MauroGianchino/Control_Horticultura/documentos/Esquematico/Proyecto_Horticultura_BOM.xls

Comment | Value | Description | Designator | Footprint | Quantity | Código DK
Battery |  | Multicell Battery | BT1 | BAT-2 | 1 | La adecuada para el PCB
Capacitor 100nF | 100nF | Capacitor | C1, C2, C3, C4, C8, C9, C10, C11, C12, C13 | RAD-0.3 | 10 | Cualquier capacitor SMD 1206 o 0603 de 16V o superior
Capacitor 1uF | 1uF | Capacitor | C5, C6 | RAD-0.3 | 2
Capacitor 10nF | 10nF x 400V | Capacitor | C7 | RAD-0.3 | 1 | B32621A6103J000
Capacitor 100uF | 100uF | Capacitor | C14 | RAD-0.3 | 1 | TAJD107K016RNJ
Capacitor 10uF | 10uF | Capacitor | C15 | RAD-0.3 | 1 | TAJD106K025RNJ
Diode_RTC_2 |  | Default Diode | D1 | SMC | 1 | B520LW-7-F
Diode_RTC_1 |  | Default Diode | D2 | SMC | 1
LED_RED |  | Typical INFRARED GaAs LED | D3 | LED-0 | 1 | WP7113SRD/J4
LED_BI_G |  | Typical INFRARED GaAs LED | D4,D5 |  | 1 | L519EGW
LED_BI_R
LED_GREEN |  | Typical INFRARED GaAs LED | D6, D7, D8 | LED-0 | 3 | WP7113GD
Diode_RELE |  | Default Diode | D9 | SMC | 1 | 1N4001 (Diotec semiconductor)
ZENER_5.1V |  | Zener Diode | D10 | DIODE-0.7 | 1 | SMBJ5338B-TP
Relay |  | SPDT Relay | K1 | MODULE5B | 1 | JW1FSN-DC12V
Header 3 |  | Header, 3-Pin | P1, P2, P3, P8 | HDR1X3 | 4 | Elegir según Nestor
MHDR1X10 |  | Header, 10-Pin | P4 | MHDR1X10 | 1 | EA DOGS164W-A
Header 2 |  | Header, 2-Pin | P5, P6, P7 | HDR1X2 | 3 | Elegir según Nestor
IRM-05-12 |  | Power Supply | PS1 | IRM0524 | 1 | IRM-05-12
PNP |  | PNP Bipolar Transistor | Q1 | SOT-23B_L | 1 | FMMT591ATA
NPN |  | NPN Bipolar Transistor | Q2, Q3, Q4, Q5, Q7 | TO-226-AA | 5 | BC817-40,215
Triac |  | Silicon Bidirectional Triode Thyristor | Q6 | 369-03 | 1 | SST137K-600E
Resistor 1k | 1K | Resistor | R1, R3, R25 | AXIAL-0.4 | 3 | Cualquier resistor SMD 1206 o 0603 0.25W al 5% o 1%
Resistor 10k | 10K | Resistor | R2, R10, R11, R15, R16, R18, R19, R20, R21, R22, R27, R28, R29, R30, R31, R32, R33 | AXIAL-0.4 | 17
Resistor 100 | 100 | Resistor | R4, R5, R7, R8, R9 | AXIAL-0.4 | 5
Resistor 50 | 50 | Resistor | R6 | AXIAL-0.4 | 1
Resistor 47k | 47k x 1W | Resistor | R12 | AXIAL-0.4 | 1 | Cualquier resistor con esas caracteristicas
Resistor 180k | 180K 1% | Resistor | R13 | AXIAL-0.4 | 1
Resistor 18k 1% | 18K 1% | Resistor | R14 | AXIAL-0.4 | 1
RPot | 100K | Potentiometer | R17 | VR5 | 1 | Elegir según Nestor
Resistor 390 | 390 | Resistor | R23, R26 | AXIAL-0.4 | 2 | Cualquier resistor con esas caracteristicas
Resistor 39 | 39 x 1W | Resistor | R24 | AXIAL-0.4 | 1
Resistor 1 | 1 x 1W | Resistor | R34 | AXIAL-0.4 | 1
SW-PB |  | Switch | S1, S2, S3, S4, S5, S6 | SPST-2 | 6 | A elegir por Nestor
Opto TRIAC |  | Opto-Triac | T1 | NPSIP4A | 1 | VO3063-X007T
ESP32-WROOM-UE32 |  | ESP32 uC | U1 |  | 1 | ESP32-WROOM-32UE-N16
LM1117MPX-3.3_NOPB |  | Integrated Circuit | U2 | SOT230P700X180-4N | 1 | LM1117MPX-3.3/NOPB
PCF85063ATT_AJ |  | Integrated Circuit | U3 | SOP65P490X110-8N | 1 | PCF85063ATT/AJ
Jumper |  | Jumper Wire | W1 | RAD-0.2 | 1 | Jumepr normal
32.768kHz |  | Crystal Oscillator | Y1 | R38 | 1 | ECS-.327-CDX-1082
