MauroGianchino/Control_Horticultura/documentos/WiFi-PWM  v02.pdf

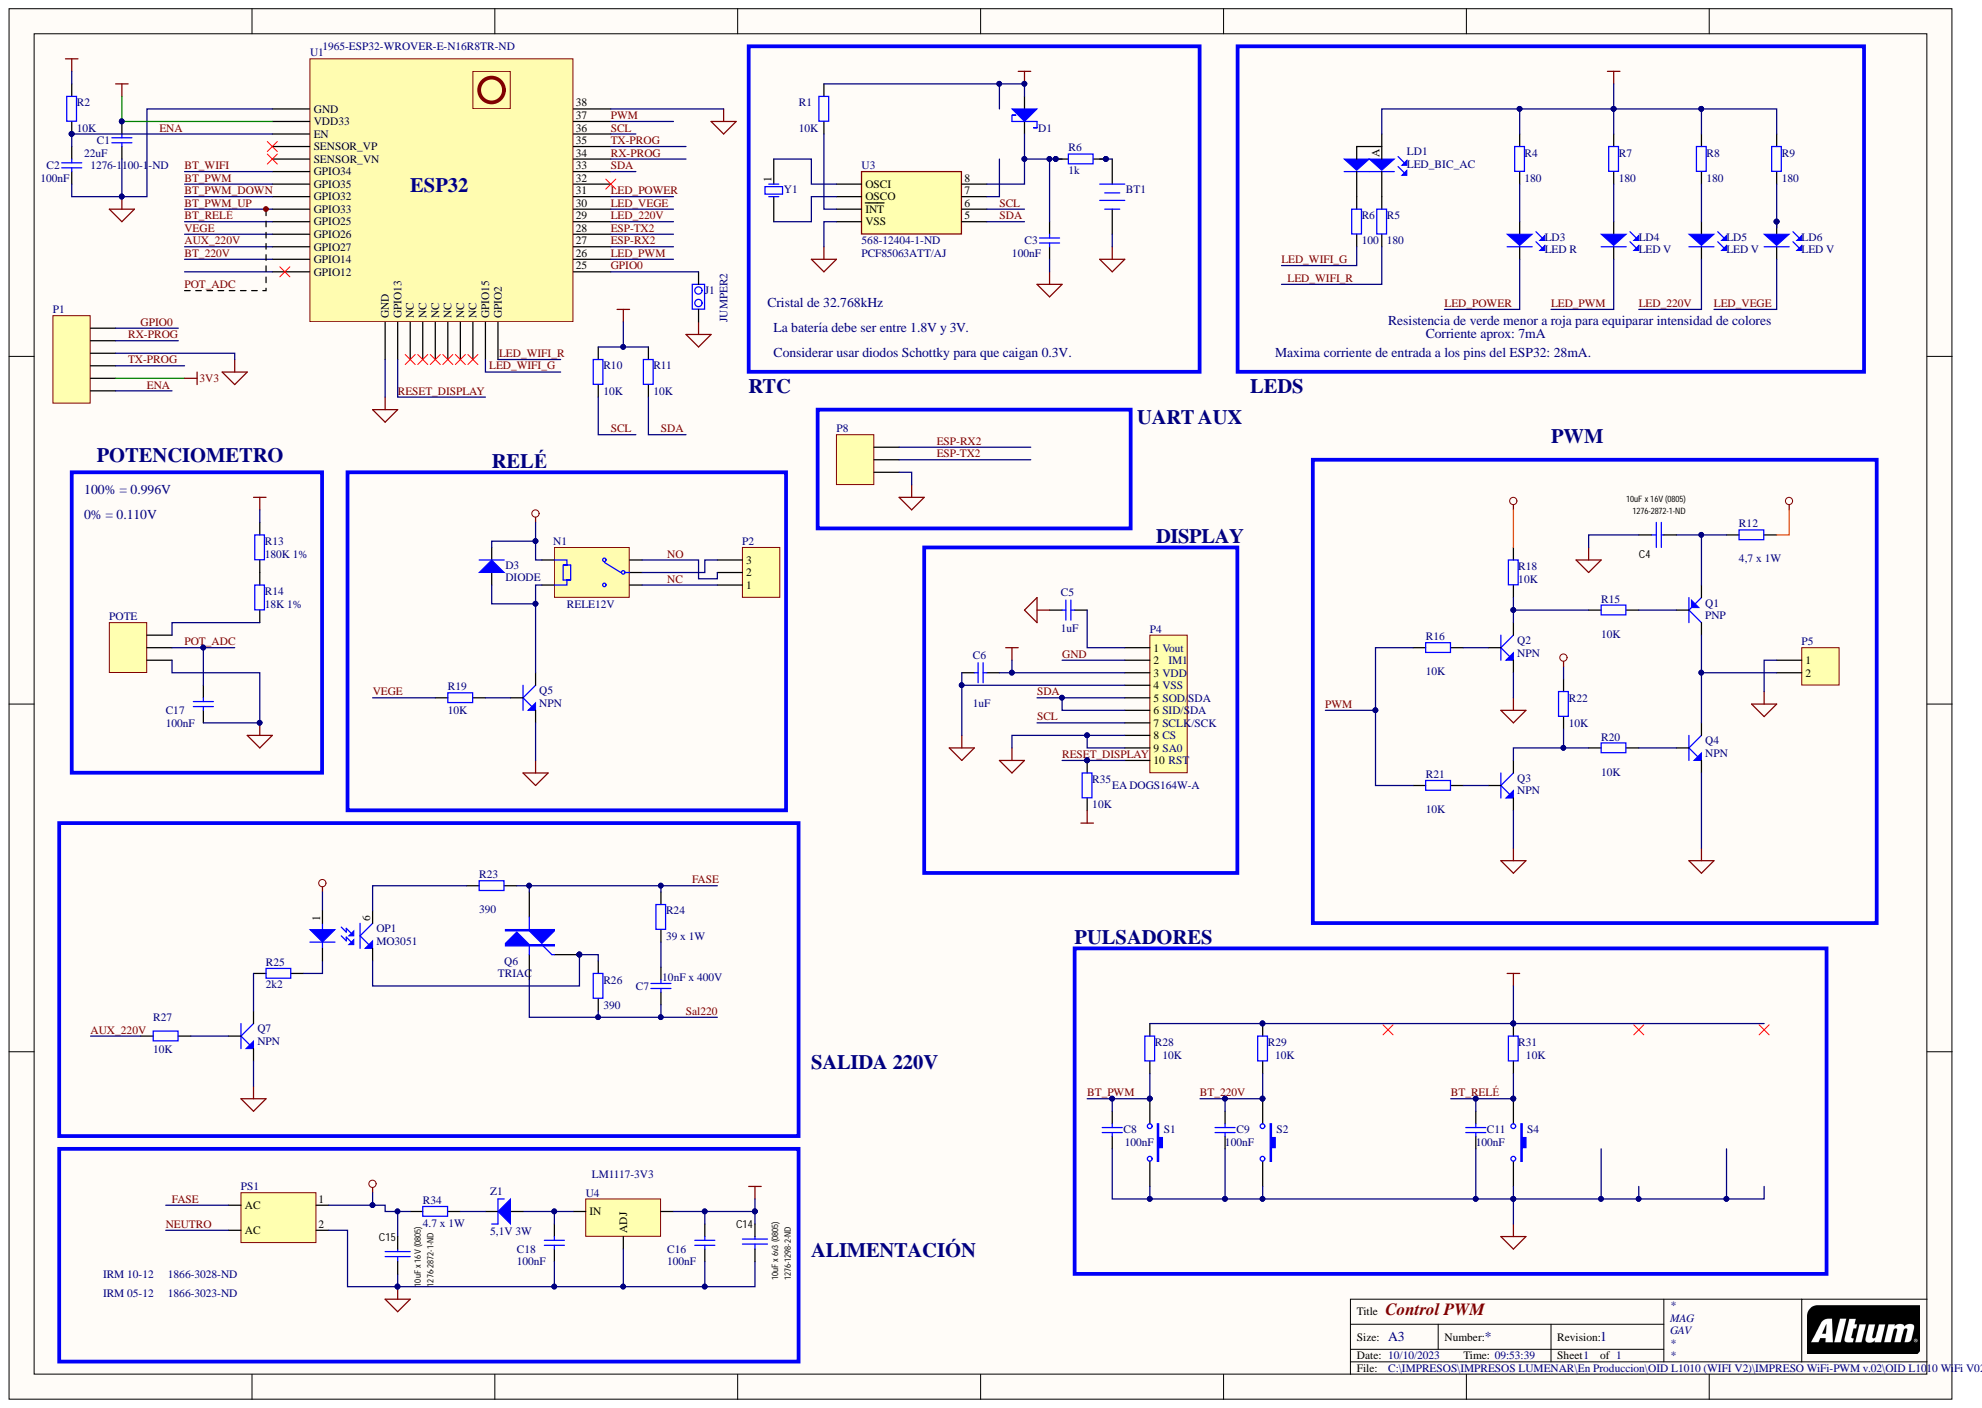
[picture p1: page 1]

La batería debe ser entre 1.8V y 3V.

Resistencia de verde menor a roja para equiparar intensidad de colores

Considerar usar diodos Schottky para que caigan 0.3V.

Maxima corriente de entrada a los pins del ESP32: 28mA.

Control PWM Title | * MAG GAV * *

Size: A3 | Number: * | Revision: 1
Date: 10/10/2023 Time: 09:53:39 | | Sheet 1 of 1

C:\IMPRESOS\IMPRESOS LUMENAR\En Produccion\OID L1010 (WIFI V2)\IMPRESO WiFi-PWM v.02\OID L1010 WiFi V02.SchDoc
