MauroGianchino/Control_Horticultura/(list of files, drawings)

Other design files:
documentos/Esquematico/Esquematico.SchDoc
