MauroGianchino/Control_Horticultura/src/button_manager.c

// NOTAS: No se puede printear ni loguear desde una ISR se reinicia el ESP32.
//--------------------INCLUDES--------------------------------------------------
//------------------------------------------------------------------------------
#include <stdio.h>

#include "freertos/FreeRTOS.h"
#include "freertos/task.h"
#include "freertos/queue.h"
#include "driver/gpio.h"
#include "sdkconfig.h"
#include "esp_log.h"

#include "esp_timer.h"

#include "../include/button_manager.h"
#include "../include/board_def.h"
#include "../include/global_manager.h"
#include "../include/nv_flash_driver.h"
#include "../include/analog_input_manager.h"
#include "../include/led_manager.h"
//--------------------MACROS Y DEFINES------------------------------------------
//------------------------------------------------------------------------------
#define QUEUE_ELEMENT_QUANTITY 20

#define TIEMPO_ANTIRREBOTE_MS 50
#define TIEMPO_PULSADO_MS 3000

//#define DEBUG_MODULE
//TO DO: ver el tema del button wifi y los led wifi
//------------------------------TYPEDEF-----------------------------------------
//------------------------------------------------------------------------------
typedef enum{
    CMD_UNDEFINED,
    STARTUP,
    DEVICE_MODE_BUTTON_PUSHED,
    TRIAC_BUTTON_PUSHED,
    VEGE_BUTTON_PUSHED,
    FABRIC_RESET,
    CALIBRATE_POTE,
}cmds_t;

typedef struct{
    cmds_t cmd;
    device_mode_status_t device_mode;
    output_mode_t triac_output_status;
}button_events_t;
//--------------------DECLARACION DE DATOS INTERNOS-----------------------------
//------------------------------------------------------------------------------
static QueueHandle_t button_manager_queue;

volatile int64_t start_time = 0;
volatile int64_t start_time_triac = 0;
volatile int64_t start_time_vege = 0;
//--------------------DECLARACION DE FUNCIONES INTERNAS-------------------------
//------------------------------------------------------------------------------
static void button_event_manager_task(void * pvParameters);

static void config_buttons_isr(void);

static void device_mode_button_interrupt(void *arg);
static void triac_button_interrupt(void *arg);
static void vege_button_interrupt(void *arg);
//--------------------DEFINICION DE DATOS INTERNOS------------------------------
//------------------------------------------------------------------------------

//--------------------DEFINICION DE DATOS EXTERNOS------------------------------
//------------------------------------------------------------------------------

//--------------------DEFINICION DE FUNCIONES INTERNAS--------------------------
//------------------------------------------------------------------------------
static void config_buttons_isr(void)
{
    gpio_config_t config;

    config.pin_bit_mask = (1ULL << VEGE_BUTTON);
    config.mode = GPIO_MODE_INPUT;
    config.pull_up_en = GPIO_PULLDOWN_ENABLE;
    config.pull_down_en = GPIO_PULLDOWN_DISABLE;
    config.intr_type = GPIO_INTR_ANYEDGE;
    gpio_config(&config);
    
    config.pin_bit_mask = (1ULL << DEVICE_MODE_BUTTON);
    config.mode = GPIO_MODE_INPUT;
    config.pull_up_en = GPIO_PULLDOWN_DISABLE;
    config.pull_down_en = GPIO_PULLDOWN_DISABLE;
    config.intr_type = GPIO_INTR_ANYEDGE;
    gpio_config(&config);

    config.pin_bit_mask = (1ULL << TRIAC_BUTTON);
    config.mode = GPIO_MODE_INPUT;
    config.pull_up_en = GPIO_PULLDOWN_DISABLE;
    config.pull_down_en = GPIO_PULLDOWN_DISABLE;
    config.intr_type = GPIO_INTR_ANYEDGE;
    gpio_config(&config);

    // Configurar la interrupción del botón
    gpio_install_isr_service(0);
    gpio_isr_handler_add(DEVICE_MODE_BUTTON, device_mode_button_interrupt, NULL);
    gpio_isr_handler_add(TRIAC_BUTTON, triac_button_interrupt, NULL);
    gpio_isr_handler_add(VEGE_BUTTON, vege_button_interrupt, NULL);
}
//------------------------------------------------------------------------------
static void IRAM_ATTR device_mode_button_interrupt(void *arg) 
{
    button_events_t ev;
    int64_t time_now = esp_timer_get_time();

    if(gpio_get_level(DEVICE_MODE_BUTTON) == 0)
    {
        start_time = time_now;
    }
    else 
    {
        if (start_time != 0)
        {
            int64_t diff = time_now - start_time;

            if (diff > 30000)  // 30ms seconds expressed in microseconds
            {
                ev.cmd = DEVICE_MODE_BUTTON_PUSHED;
                start_time = 0;
                xQueueSendFromISR(button_manager_queue, &ev, pdFALSE);
            }
            if (diff > 7000000)  // 7 seconds expressed in microseconds
            {
                ev.cmd = FABRIC_RESET;
                start_time = 0;
                xQueueSendFromISR(button_manager_queue, &ev, pdFALSE);
            }
            start_time = 0;
        }
    }
}
//------------------------------------------------------------------------------
static void IRAM_ATTR triac_button_interrupt(void *arg) 
{
    button_events_t ev;
    int64_t time_now = esp_timer_get_time();

    if(gpio_get_level(TRIAC_BUTTON) == 0)
    {
        start_time_triac = time_now;
    }
    else 
    {
        if (start_time_triac != 0)
        {
            int64_t diff = time_now - start_time_triac;
            if (diff > 30000)  // 30ms seconds expressed in microseconds
            {
                ev.cmd = TRIAC_BUTTON_PUSHED;
                start_time_triac = 0;
                xQueueSendFromISR(button_manager_queue, &ev, pdFALSE);
            }
            if (diff > 7000000) // 7 seconds expressed in microseconds
            {
                ev.cmd = CALIBRATE_POTE;
                start_time_triac = 0;
                xQueueSendFromISR(button_manager_queue, &ev, pdFALSE);
            }
            start_time_triac = 0;
            
        }
    }
}
//------------------------------------------------------------------------------
static void IRAM_ATTR vege_button_interrupt(void *arg) 
{
    button_events_t ev;
    int64_t time_now = esp_timer_get_time();

    if(gpio_get_level(VEGE_BUTTON) == 0)
    {
        start_time_vege = time_now;
    }
    else 
    {
        if (start_time_vege != 0)
        {
            int64_t diff = time_now - start_time_vege;

            if (diff > 30000)  // 30ms seconds expressed in microseconds
            {
                ev.cmd = VEGE_BUTTON_PUSHED;
                xQueueSendFromISR(button_manager_queue, &ev, pdFALSE);
            }
            start_time_vege = 0;
        }
    }
}
//------------------------------------------------------------------------------
void button_manager_send_startup_info(device_mode_status_t device_mode, output_mode_t triac_output_status)
{
    button_events_t ev;
    ev.cmd = STARTUP;
    ev.device_mode = device_mode;
    ev.triac_output_status = triac_output_status;
    xQueueSend(button_manager_queue, &ev, 30 / portTICK_PERIOD_MS);
    
}


void button_event_manager_task(void * pvParameters)
{
    button_events_t button_ev;
    
    device_mode_status_t device_mode = DEVICE_IN_MANUAL;
    output_mode_t triac_status = MANUAL_OFF;
    rele_output_status_t rele_vege_status = RELE_VEGE_DISABLE;
#ifdef DIGITAL_POTE
    uint8_t pwm_percent_power = 0;
#endif

    config_buttons_isr();

    while(true)
    {
        if(xQueueReceive(button_manager_queue, &button_ev, portMAX_DELAY) == pdTRUE)
        {
            switch(button_ev.cmd)
            {
                case STARTUP:
                    device_mode = button_ev.device_mode;
                    triac_status = button_ev.triac_output_status;
                    break;
                case CMD_UNDEFINED:
                    break;
                case DEVICE_MODE_BUTTON_PUSHED:
                    led_manager_new_update();
                    if(device_mode == DEVICE_IN_MANUAL)
                    {
                        global_manager_set_triac_mode_off(false);
                        triac_status = MANUAL_ON;       
                        global_manager_set_pwm_mode_manual_on();
                        device_mode = DEVICE_IN_AUTOMATIC;
                        analog_input_send_pwm_mode(MANUAL_ON);
                        
                    }
                    else if(device_mode == DEVICE_IN_AUTOMATIC)
                    {
                        analog_input_send_pwm_mode(AUTOMATIC);
                        global_manager_set_pwm_mode_auto();
                        global_manager_set_triac_mode_auto(false);
                        device_mode = DEVICE_IN_MANUAL;
                    }
                    break;
                case TRIAC_BUTTON_PUSHED:
                    led_manager_new_update();
                    if(device_mode == DEVICE_IN_AUTOMATIC)
                    {
                        if(triac_status == MANUAL_OFF)
                        {
                            global_manager_set_triac_mode_off(false);
                            triac_status = MANUAL_ON;
                        }
                        else if(triac_status == MANUAL_ON)
                        {
                            global_manager_set_triac_mode_manual_on(false);
                            triac_status = MANUAL_OFF;
                        }
                    }
                    break;
                case VEGE_BUTTON_PUSHED:
                    led_manager_new_update();
                    if(rele_vege_status == RELE_VEGE_DISABLE)
                    {
                        global_manager_set_rele_vege_status_off(false);
                        rele_vege_status = RELE_VEGE_ENABLE;
                    }
                    else if(rele_vege_status == RELE_VEGE_ENABLE)
                    {
                        global_manager_set_rele_vege_status_on(false);
                        rele_vege_status = RELE_VEGE_DISABLE;
                    }
                    break;
                case FABRIC_RESET:
                    led_manager_new_update();
                    nv_flash_driver_erase_flash();
                    break;
                case CALIBRATE_POTE:
                    led_manager_new_update();
                    analog_input_calibrate_pote();
                    break;
                default:
                break;
            }
        }
    }
}
//--------------------DEFINICION DE FUNCIONES EXTERNAS--------------------------
//------------------------------------------------------------------------------
void button_manager_init(void)
{
    button_manager_queue = xQueueCreate(QUEUE_ELEMENT_QUANTITY, sizeof(button_events_t));

    xTaskCreate(button_event_manager_task, "button_event_manager_task", 
               configMINIMAL_STACK_SIZE*5, NULL, configMAX_PRIORITIES, NULL);             
}
//--------------------FIN DEL ARCHIVO-------------------------------------------
//------------------------------------------------------------------------------
