MauroGianchino/Control_Horticultura/src/version.c

//--------------------INCLUDES--------------------------------------------------
//------------------------------------------------------------------------------
#include <stdio.h>
#include <string.h>
#include <assert.h>

#include "sdkconfig.h"

#include "../include/version.h"
//--------------------MACROS Y DEFINES------------------------------------------
//------------------------------------------------------------------------------
#define VERSION "2.3"
//------------------- TYPEDEF --------------------------------------------------
//------------------------------------------------------------------------------

//------------------- DECLARACION DE DATOS LOCALES -----------------------------
//------------------------------------------------------------------------------

//------------------- DECLARACION DE FUNCIONES LOCALES -------------------------
//------------------------------------------------------------------------------

//------------------- DEFINICION DE DATOS LOCALES ------------------------------
//------------------------------------------------------------------------------

//------------------- DEFINICION DE DATOS GLOBALES -----------------------------
//------------------------------------------------------------------------------

//------------------- DEFINICION DE FUNCIONES LOCALES --------------------------
//------------------------------------------------------------------------------

//------------------- DEFINICION DE FUNCIONES EXTERNAS -------------------------
//------------------------------------------------------------------------------
void get_version(char *version, uint8_t *version_len)
{
    strcpy(version, VERSION);
    *version_len = strlen(version);
}
//---------------------------- END OF FILE -------------------------------------
//------------------------------------------------------------------------------
