MauroGianchino/Control_Horticultura/include/button_manager.h

#ifndef BUTTON_MANAGER_H__
#define BUTTON_MANAGER_H__
//--------------------INCLUDES--------------------------------------------------
//------------------------------------------------------------------------------
#include "../include/global_manager.h"

//--------------------MACROS Y DEFINES------------------------------------------
//------------------------------------------------------------------------------

//--------------------TYPEDEF---------------------------------------------------
//------------------------------------------------------------------------------
typedef enum{
    DEVICE_IN_MANUAL = 0,
    DEVICE_IN_AUTOMATIC = 1,
}device_mode_status_t;
//--------------------DECLARACION DE DATOS EXTERNOS-----------------------------
//------------------------------------------------------------------------------

//--------------------DECLARACION DE FUNCIONES EXTERNAS-------------------------
//------------------------------------------------------------------------------
void button_manager_init(void);
void button_manager_send_startup_info(device_mode_status_t device_mode, output_mode_t triac_output_status);

//--------------------FIN DEL ARCHIVO-------------------------------------------
#endif /* BUTTON_MANAGER_H__ */
