MauroGianchino/Control_Horticultura/include/pcf85063.h

#ifndef PCF85063_H__
#define PCF85063_H__
//------------------- INCLUDES -------------------------------------------------
//------------------------------------------------------------------------------

//------------------- MACROS Y DEFINES -----------------------------------------
//------------------------------------------------------------------------------

//------------------- TYPEDEF --------------------------------------------------
//------------------------------------------------------------------------------

//------------------- DECLARACION DE DATOS EXTERNOS ----------------------------
//------------------------------------------------------------------------------

//------------------- DECLARACION DE FUNCIONES EXTERNAS ------------------------
//------------------------------------------------------------------------------
void pcf85063_init(void);
void pcf85063_set_current_time(struct tm current_time);
uint8_t pcf85063_get_current_time_info(struct tm *current_time);

//------------------- FIN DEL ARCHIVO ------------------------------------------
#endif /* PCF85063_H__ */
