MauroGianchino/Control_Horticultura/include/wifi_manager.h

#ifndef WIFI_MANAGER_H__
#define WIFI_MANAGER_H__
//------------------- INCLUDES -------------------------------------------------
//------------------------------------------------------------------------------

//------------------- MACROS Y DEFINES -----------------------------------------
//------------------------------------------------------------------------------

//------------------- TYPEDEF --------------------------------------------------
//------------------------------------------------------------------------------

//------------------- DECLARACION DE DATOS EXTERNOS ----------------------------
//------------------------------------------------------------------------------

//------------------- DECLARACION DE FUNCIONES EXTERNAS ------------------------
//------------------------------------------------------------------------------
void wifi_manager_init(void);

//------------------- FIN DEL ARCHIVO ------------------------------------------
#endif /* WIFI_MANAGER_H__ */
