MauroGianchino/Control_Horticultura/include/vege_manager.h

#ifndef VEGE_MANAGER_H__
#define VEGE_MANAGER_H__
//------------------- INCLUDES -------------------------------------------------
//------------------------------------------------------------------------------

//------------------- MACROS Y DEFINES -----------------------------------------
//------------------------------------------------------------------------------

//------------------- TYPEDEF --------------------------------------------------
//------------------------------------------------------------------------------

//------------------- DECLARACION DE DATOS EXTERNOS ----------------------------
//------------------------------------------------------------------------------

//------------------- DECLARACION DE FUNCIONES EXTERNAS ------------------------
//------------------------------------------------------------------------------
void vege_manager_init(void);

void vege_manager_turn_on(void);
void vege_manager_turn_off(void);
//------------------- FIN DEL ARCHIVO ------------------------------------------
#endif /* VEGE_MANAGER_H__ */
