MauroGianchino/Control_Horticultura/include/triac_manager.h

#ifndef TRIAC_MANAGER_H__
#define TRIAC_MANAGER_H__
//------------------- INCLUDES -------------------------------------------------
//------------------------------------------------------------------------------

//------------------- MACROS Y DEFINES -----------------------------------------
//------------------------------------------------------------------------------

//------------------- TYPEDEF --------------------------------------------------
//------------------------------------------------------------------------------

//------------------- DECLARACION DE DATOS EXTERNOS ----------------------------
//------------------------------------------------------------------------------

//------------------- DECLARACION DE FUNCIONES EXTERNAS ------------------------
//------------------------------------------------------------------------------
void triac_manager_init(void);

void triac_manager_turn_on_triac(void);
void triac_manager_turn_off_triac(void);
//------------------- FIN DEL ARCHIVO ------------------------------------------
#endif /* TRIAC_MANAGER_H__ */
