MauroGianchino/Control_Horticultura/(commit log)

2023-05-24 Update led_manager_module
2023-05-25 Update platform.ini
    Configuration:
    platform = espressif32
    board = esp32dev
    framework = espidf
    monitor_speed = 115200
    Upload_port = COM3
    build_type = release
    board_upload.flash_size = 4MB
    monitor_filters = esp32_exception_decoder
2023-05-25 New board_def.h module
    Module for board definitions
2023-05-25 Update led manager module with device leds
2023-05-26 Update led manager module
    New functions to interact with led module from other modules.
2023-05-27 Update led manager module
    New functions to manage leds states
2023-05-28 Updating led module with blinking leds
2023-05-29 agrego primera version de esquematico
2023-05-29 Ajuste de valores
2023-05-31 New module button_manager
    Button push detection is managed with external interrupts
2023-05-31 Updating button manager
2023-05-31 update board_def module with pin definitions
2023-05-31 Actualizacion de esquemático. Cambio de simbolo de ESP32. Valores de potenciometro. Resistencias de LEDS
2023-06-01 Update develop_pulsadores
    The module has been updated with the isrs
    for all button readings.
2023-06-01 creo nueva branch y nueva version de esquematico. Asigné lo pines al ESP32 y agregue los capacitores a los botones.
2023-06-01 removi el esquematico V2
2023-06-02 agregaod de uart auxiliar
2023-06-03 Correcciones de esquematico y agrada de lista de componentes
    [Proyecto_Horticultura_BOM.xls]
2023-06-03 Upgrading led_manager and button_manager module
2023-06-03 update board_def
2023-06-03 agrego detalles de la bateria
2023-06-03 agrego archivo del Altium
    [Esquematico.SchDoc]
2023-06-08 arreglo el led bicolor y cambio jumper por pulsador
    [Esquematico.SchDoc]
2023-07-31 Update button manager module
2023-07-31 New module pwm_manager
2023-07-31 Update pwm module
    Added functions for turning on and off pwm while
    day simulation function is turn on
2023-07-31 New feature: pwm automatic manager
2023-07-31 Code working on prototype
    must use esp-prog for programming
    [custom.csv]
2023-07-31 Update buttons module
2023-07-31 Init and save pwm mode on flash
2023-07-31 Resuelto: TO DO: resolver el problema lectura str
    [nv_flash_manager.c]
2023-07-31 Update pwm auto calendar from flash done
2023-07-31 testing pwm auto mode
2023-07-31 PWM AUTO done
2023-07-31 save current time on flash done
2023-07-31 update rele vege
    hay que ver que onda porque no mueve la salida
2023-08-01 agrego los modulos de ap y webserver. Cambio lo de la memoria a 4MB
    [custom.csv]
2023-08-01 agrego los ceros en la web para numeros menores a 10
2023-08-02 agrego las funciones de global manager para guardar los valores de todos los parametros. Falta usar las de lectura para mostrarlas en la web
2023-08-04 agrego el modulo del current_time
2023-08-06 agrego la lectura de todos los parametros a partir de las funciones de gaston. Hay problemas con el triac y vegeflor, que esta levantando mal los datos. tambien falta hacer el cambio de ssid y passwo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
    [global_manager.c, web_server.c, web_server.h, wifi_ap.c]
2023-08-06 solve wb_server get_triac issue
    [custom.csv]
2023-08-07 Change ADC_POTE pin from GPIO 12 to GPIO33
    Due a problema while Aorking with ADC2 and WIFI module
    [analog_input_manager.c, board_def.h, button_manager.c, current_time_manager.c, global_manager.c, led_manager.c, nv_flash_driver.c, pwm_manager.c]
2023-08-08 arreglo sintaxis de web, arreglo enable de los checkbox segun el modo del triac. agrego actualizacion de hora en la web cad aun segundo
    [custom.csv]
2023-08-08 agrego el reseteo de los horarios del triac
    [web_server.c, web_server.h]
2023-08-09 Arreglo funcionamiento pulsador PWM
    [custom.csv]
2023-08-12 Resuelve problema de muestra de intensidad de pwm
    Resuelve problema de muestra de intensidad de pwm en webpage
    cuadno se trabaja en manual.
    [global_manager.c]
2023-08-12 Chequea toff y ton para el pwm y el triac
    Chequea que toff sea mayor que ton al momento de configurar
    los parametros del triac y el pwm en modo automatico.
2023-08-12 Simul day habilitado 30m dif en calendar pwm
    Si esta el simul day habilitado debe haber 30 minutos de diferencia
    entre ton y toff para que se guarden los valores de calendario.
2023-08-14 cambio la logica de la pagina html de configuracion. Se muestran los valores actuales. Los horarios en las casillas correspondientes. Los datos de la red actuales. Agrego en el armado de los JSON los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
2023-08-15 agrego mejoras en la pagina web. Se soluciona el tema de los horarios del triac que hacia que no se vea el deschequeo. hay problema con el valor de los horarios del pwm levantados de la flash.
    [custom.csv]
2023-08-16 solucionada la carga de los valores en la web de configuracion. Solucionada la habilitacion de los checkboxs, barra y horarios en funcion de los valores cargados. Los fetch ocurren antes de entrar a 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
    [web_server.c]
2023-08-18 Corrige el prob de la info del calendar del pwm
    [custom.csv]
2023-08-24 agrego el logo en las dos webs. agrego el handler para la imagen. agrego el estilo (CSS) en la web de configuracion. Incremento el stack del httpd 250k.
    [custom.csv]
2023-08-25 Bug fix: config rele_vege
    [custom.csv]
2023-08-25 Update gpio output configs (leds configs)
2023-08-25 change led toggle frequency
2023-08-26 SSID and PASSWORD WIFI config through flash
    Se configura el SSID y el PASSWORD de la web desde los parametros g
    guardados en flash.
    Si por alguna causa no se puede leer alguno de los dos parametros se
    utiliza su parametro default:
    EXAMPLE_ESP_WIFI_SSID "Red_Hor"
    EXAMPLE_ESP_WIFI_PASS "Horti2505"
    Si la longitud del password guardada por el usuario es menor a 8
    caracteres se utiliza el password default ya que no se cumple con la
    norma y la conexion explota. Se hace por seguridad. El password
    ingresado debe tener entre 8 y 63 caracteres.
2023-08-26 agrego diseño a la web del index y arreglo un par de cositas
    [custom.csv]
2023-08-26 last updates
    [custom.csv]
2023-08-27 modifico los diseños de las web y cambio el lofo del wifi
2023-09-06 pwm info webpage update
2023-09-06 Pin switch between rele vege and triac button
2023-09-08 Se acomoda el funcionamiente del rele vege
    Se acomoda el funcionamiente del rele vege al funcionamiento nuevo
    que pidieron en los ultimos cambios:
    LED rele vege on -> estado vegetativo -> toma el rele
    LED rele vege off -> estado floracion -> libera el rele
2023-09-08 mejora deteccion de pulsadores
2023-09-08 Termino de corregir la deteccion de los pulsadores
2023-09-10 modifico un poco el index y el config
    [custom.csv]
2023-09-11 Working on triac auto mode.
    Ya funciona, queda corregir lo siguiente:
    - Cuando inicia antes del primer ciclo Ton, si muevo a ON manual
    y luego muevo a auto la salida de 220 del triac no se apaga.
    Solo pasa en este caso.
    - El toggle de la salida de 220 ocurre 1 minuto despues de los Ton
    y Toff configurados.
    [custom.csv]
2023-09-11 adapto mejor la web de config a responsive. la hora se obtiene del Date en JS automaticamente y se manda cuando se apreta sincronizar. se agregan media queries. todos los hoarios son configurables en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
2023-09-13 arreglo la barra de potencia y la muestra del estado de vegetaicon en config. Falta chequear la contrasenia con 8 caracteres y arreglar que al entrar al config el valor del pwm no aparece el porcient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
2023-09-14 Se cambia el guardado de hora en flash por el rtc
2023-09-15 arreglo la actualizacion de la hora en la web de config. meto la funcion de refresco dentro del intervalo de 1 segundo para que se aactualice cada ese tiempo. También agrego el la primera vez que se 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
2023-09-17 corrijo la sincronizacion de la hora borrando funciones que quedaban que no usaba
2023-09-17 pwm auto update
2023-09-18 Cuando esta conectado el ADC no lee los pulsadores
2023-09-19 Buttons functionality changed. POTE bug fixed.
    - Button PWM pasa a ser DEVICE_MODE_BUTTON:
    En lugar de cambiar de estado del pulsador cambia el modo del
    dispositivo:
    - Modo Manual o Modo Automatico.
    - Este modo es valido tanto para la salida del TRIAC como para
    la salida del PWM.
    - TRIAC button pasa a controlar 2 estados en lugar de 3:
    Controla TRIAC ON y TRIAC OFF cuando el dispositivo se encuentra
    en modo manual.
    Si el dispositivo NO se encuentra en modo manual entonces no cambia
    el estado del TRIAC.
    - Con estos cambios se resolvio el problema del uso de los botones cuando
    estaba el pote conectado.
    [board_def.h, button_manager.c]
2023-09-19 Modo de dispositivo desde web_server
    Se modifica la transicion de modos del pwm y el triac de la siguiente forma:
    - TRIAC modo ACTIVAR -> PWM MANUAL
    - TRIAC modo NO -> PWM MANUAL
    - TRIAC modo AUTO -> PWM AUTOMATICO
    - PWM MANUAL -> TRIAC modo NO (ARRANCA APAGADO)
    - PWM AUTOMATICO -> triac MODO AUTO
    - PWM APAGADO -> no hace nada (este estado se podria sacar de la web)
2023-09-19 agrego en la web del index el estado de la salida del PWM y del triac. Agrego este estado en sus JSON
2023-09-21 Se hace mas fluida la lectura del pote
    Lectura del ADC cada 40ms en lugar de cada 100ms como estaba.
    Esto fue pedido por nestor en la devolucion v3.
2023-09-21 Se agrega el funcionamiento del led device mode
    (ex LED PWM)
    - Si el equipo se encuentra en manual parpadea.
    - Si el equipo se encuentra en automatico se queda encendido fijo.
2023-09-21 Cambio el funcionamiento del led del triac
    - Salida TRIAC ON -> LED TRIAC ENCENDIDO
    - Salida TRIAC OFF -> LED TRIAC APAGADO
2023-09-21 working on bicolor led
2023-09-22 led bicolor implementado. glitch pwm fixed.
    Se soluciona el apagado del pwm cuando se pasaba el pwm a automatico.
    Se agrego una condicion al modulo pwm automatico:
    si Ton > current_time y Toff > Ton -> output_status_pwm = OFF
    [analog_input_manager.c, board_def.h, global_manager.c, led_manager.c, led_manager.h, pwm_auto_manager.c]
2023-09-22 Ajuste led device mode - LED ON -> Device mode auto - LED OFF -> Device mode manual
2023-09-23 minimum pwm value updated
    Se configuro el valor del pwm minimo para que sea 10 porciento:
    - Para modo automatico PWM mínimo 10 porciento.
    - Para modo manual (valor pwm medido del pote) se enmascaran
    las lecturas que generan un pwm menor a 10 porciento de ciclo
    de trabajo. Para esos casos pwm = 0 y cuando es mayor o igual a 10
    la salida será la leida por el ADC del pote.
    - Para automatico con amanecer/atardecer habilitados la salida del
    pwm arranca en 10 porciento y en atardecer cuando llega a 9 porciento
    la salida de pwm pasa a ser 0.
2023-09-23 Update bicolor led functionality
2023-09-23 Bug fixed: en auto Ton y Toff en el minuto justo
    Se corrige el problema de encendido y apagado de PWM y/o TRIAC por
    el cual se llegaba a la condicion de Ton o Toff 1 minuto mas tarde
    del tiempo configurado por web.
    Ahora ocurre en el tiempo configurado justo.
    [global_manager.c, pwm_auto_manager.c, triac_auto_manager.c]
2023-09-24 Bgu fixed: fading ofarranqeu 15 min antes de toff
    Se modifico el driver de pwm_auto_manager para que el fading off
    arranque 15 minutos antes de toff cuando el equipo
    posee la funcion amanecer/atardecer habilitada.
    Por el tema que se apaga el pwm por debajo de 10 porciento puede
    ser que el fading off concluya 1 o 2 minutos antes de toff.
    [pwm_auto_manager.c]
2023-09-24 Arreglos en index: resuelvo los ticks y x en triac, ya no se overlapean. ajusto posicion del circulo indicar de estado de salida.quito la muestra de contraseña. Arreglos en config: hago automatico el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
    [web_server.c]
2023-09-24 corrijo el mensaje de alerta de los post
2023-09-24 Se agrega la secuencia de reset de fabrica
    Se debe presionar durante 10 segundos el pulsador de modo (Auto/manual).
    Luego corre un timer de 1 segundo.
    Luego del segundo se reinicia el micro y levanta la config default.
    [button_manager.c, nv_flash_driver.c, nv_flash_manager.c]
2023-09-25 Last updates on leds module
2023-09-27 Reseteo de ESP32 luego de config SSID y PASSWORD
    Se agrega el reseteo del ESP32 luego de 2 segundos de haber
    configurado el password y el ssid de la red wifi.
    El usuario se va a tener que loguear nuevamente despues del cambio.
    [web_server.c]
2023-09-27 bug fix: en auto no se reajustaba la salida de pwm
    - En auto, si reajustabas el valor del pwm y actualizabas,
    no actualizaba la salida. Pero en la web dice el nuevo valor.
    Se ajusto para que se reajsute y además si se encuentra en amanecer
    o atardecer no permite modificar el valor.
    Si en las partes de salida ON.
    [global_manager.c, pwm_auto_manager.c, pwm_manager.c, pwm_manager.h]
2023-09-28 agrego la verificacion de los horarios del triac. está contemplado el cambio de día. Hacer más pruebas
2023-09-28 En amanecer/atardecer no se puede cambiar simulday
    Si la salida de pwm se encuentra en el ciclo de amanecer o atardecer
    no se puede cambiar por web la funcion de simulday de SI a NO.
2023-09-28 Bug fix:update pwm transicion manual a auto en on
    Si se pasaba a manual el PWM cuando la saldia estaba en auto, tomaba
    el pote ok, pero cuando volvia a auto, no tomaba el valor que tenia
    ajustado en automatico.
    Se corrigio esto para el caso en que se pase de auto a manual y
    para el caso que se pase de auto a manual con simulday activado.
    [global_manager.c, pwm_auto_manager.c, pwm_auto_manager.h]
2023-09-29 Cambia funcionamiento de led bicolor a pedido
    Se Cambio funcionamiento de led bicolor a pedido de nestor.
    Cuando se encuentra en atardecer o amanecer:
    - LED ROJO ON, LED VERDE OFF 500ms
    - LED VERDE ON, LED ROJO OFF 500ms
    - LED VERDE ON, LED ROJO ON 500ms
    En 200ms no se distinguia bien.
    Para manual/automatico se dejo una frecuencia fija, los updates en manual
    de pwm hacia que se vea mal el led si lo hacia como dijo nestor.
    Se agrega el funcionamiento de led de power:
    - LED POWER ON 2s.
    - LED POWER OFF 100ms.
2023-09-29 Toggle led power frente a cambios
    Se agrega un toggle del led de power con un paso de 50 ms durante 0,5 seg
    que se ejecuta frente a un cambio de configuracion.
    Este cambio de configuracion puede estar dado por el pulsado de un boton
    o por una modificacion por pagina web.
2023-09-29 Bug fix: inicio de amanecer y fin de atardecer
    Pasaba que cuando iniciaba la rampa tardaba maximo 30 segundos en
    arrancar a crecer desde 10 porciento. Se ajusto para qeu y bien se detecte
    el inicio de la rampa tenga saldia 10 porciento.
    Pasaba que devido a que arrancaba tarde terminaba antes en un 15/20 porciento
    de pwm. Con la modificacion anterior llega mas cercando al 10 porciento
    de pwm a apagarse. Hay que tener en cuenta la resolcion del paso de
    decrecimiento eso va a definir el posible error.
    resolucion paso = pwm power percentage / 30
    Donde 30 es la cantidad de pasos para que la rampa crezca y decrezca
    en 15 minutos.
    [led_manager.c, pwm_manager.c]
2023-09-29 agrego la verificacion de mas casos de horarios no válidos en triac.
2023-09-30 Bug fix: pwm auto
    El pwm no iniciaba en automatico cuando se cumplia la condicion de
    encendido y Toff > Ton
    [pwm_auto_manager.c]
2023-09-30 bug fix: triac auto turn on
    Cuando se configuraba el triac en automatico y se cumplia la condicion
    de encendido y Ton > Toff no se encendia la salida del triac.
    [triac_auto_manager.c]
2023-09-30 bug bix: estado inicial de botones en startup
    Se corrige el estado inicial de lso botones segun configuracion
    guardada en flash.
    [button_manager.c, global_manager.c]
2023-09-30 arreglo cuando se toma la hora a las 00.xx en la web config
    [web_server.c]
2023-10-01 Cuando se actualizan los parametros en el /config, si son correctos, primero se envia el post y despues sale el cartel de aviso si son correctos. tambien corrijo las oraciones de las alertas
2023-10-04 bug fix: triac auto turn off y pwm after reset fade off
    Solucina el bug del triac de turn off en automatio que
    parpadeaba luego de llegar a toff.
    Souluciona el bug del pwm en fade off que cuand ose reiniciaba el
    micro en ese estado arrancaba siemrpe de 50 porciento.
    [pwm_auto_manager.c, pwm_manager.c, pwm_manager.h, triac_auto_manager.c]
2023-10-18 Apaga PWM frente a presion de button rele vege
    Apaga PWM frente a presion de button rele vege en manual y en auto
    cuando no hay amanecer ni atardecer.
2023-10-18 Se agrega apagado y encendido de pwm en fading
2023-10-19 Agrego un tiempo de off de 800ms del led en el cambio de cada color cuando es la rampa
2023-10-20 New feature: off/on pwm al conmutar rele vege
    Se agrega el off 200ms conmutar rele y 200ms y on a pedido de nestor.
    Se tuvieron en cuenta lso siguientes casos:
    - Manual
    - Automatico en on y en off
    - Automatico con amanecer y atardecer habilitado:
    - off
    - on
    - amanecer / atardecer: guarda estado al volver del apagado
    Fue probado funciona ok
2023-10-27 Elimino validaciones de pwm en rampa
    Se hacian validaciones para evitar que se modifique el pwm o la habilitacion
    de la rampa cuando el equipo estaba en rampa.
    Esto no gusto, entonces se elimina.
2023-10-29 Bug fix: simul_day_on, no rampa, update pwm rampa
    En automático, con simulacion de amanecer / atardecer habilitado, en el
    rango por fuera de la rampa, cuando se hacia un update pwm se iniciaba
    nuevamente la rampa.
    Se corrigio esto para que actualice el pwm a la salida únicamente.
    [pwm_auto_manager.c]
2023-10-29 Mejoras cambio de calendar pwm pwm_auto
    Falta contemplar el siguiente caso:
    - Configuracion pwm en automatico con simul_day activado:
    horario dentro del rango pwm_on y por fuera de amanecer/atardecer
    entonces tengo la salida en on.
    Cambio a amancer y no arranca a hacer el amanecer queda en on.
    Habria que ver que pasa con el mismo caso pero en atardecer.
    Todos los demás casos los contempla.
2023-10-29 Bug fix: led bicolor
    No tomaba en cuenta los casos en que el PWM estaba en 10 o en 100
    en automatico.
    [led_manager.c]
2023-10-29 Cambio de pwm calendar ultiams correcciones
    Ya contempla todos los casos
2023-10-29 Bug fix: led bicolor
    Cuando se pasaba de manual a auto. El led bicolor no tomaba el valor
    de pwm para el parpadeo en automático.
    [global_manager.c]
2023-10-30 aumento t apagado pwm en accionado rele vege 50ms
2023-11-28 guardado en flash de la variable max pote ref
2023-12-01 New feature: potentiometer calibration
    Se finaliza la nueva funcionalidad para
    calibración de potenciometro.
    Cosas a tener en cuenta:
    - Por default el equipo se configura al fondo de escala según el
    esquemático original.
    - Si vuelvo el equipo a configuración de fábrica hay que calibrar
    nuevamente el potenciómetro.
    Procedimiento para llevar a cabo la calibración del pote:
    - Ajustar el potenciómetro en fondo de escala.
    - Mantener presionado el botón de on/off del triac durante 7 segundos y soltarlo.
    - Parpadeara el led rojo de source indicando que se ha ejecutado una acción.
    - Se guarda el nuevo fondo de escala del potenciometro en memoria no volátil.
    - Luego de 3 segundos se rein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
2023-12-03 led_power change from GPIO_OUTPUT_19 to GPIO_OUTPUT_12
    Update version from 1.0 to 2.0 due new feature added.
    [Esquematico.SchDoc, Proyecto_Horticultura_BOM.xls]
2023-12-03 New static ip 192.168.4.2
    Se cambia la metodologia de asignacion de ip
    de DHCP a estatica para uan fija elegida por
    Nestor.
2023-12-05 trabajando en version 2.1
    Agrego parte de mauro de la web nueva.
    Bug fix: Cuando iniciaba el equipo en automatico el led bicolor
    se encendia auque la salida del pwm se encontrara apagada.
    Se aumenta el numero de version a 2.1.
    [global_manager.c, version.c, web_server.c, web_server.h, wifi_ap.c]
2023-12-07 agrego modificaciones en el index, en el cing y en el parseo manual del triac
2023-12-07 czmbio el verde a uno mas oscuro en el index
2023-12-18 Agrego verificacion de horario de pwm. no pueden ser ambos horarios iguales. agrego redireccion al index en el config luego de actualizar
2023-12-20 Bug fix: recta de lectura adc
    [analog_input_manager.c, version.c]
